wybieracz/IoT-Smart-Light-Firmware/Documentation/Circuit_diagram.pdf

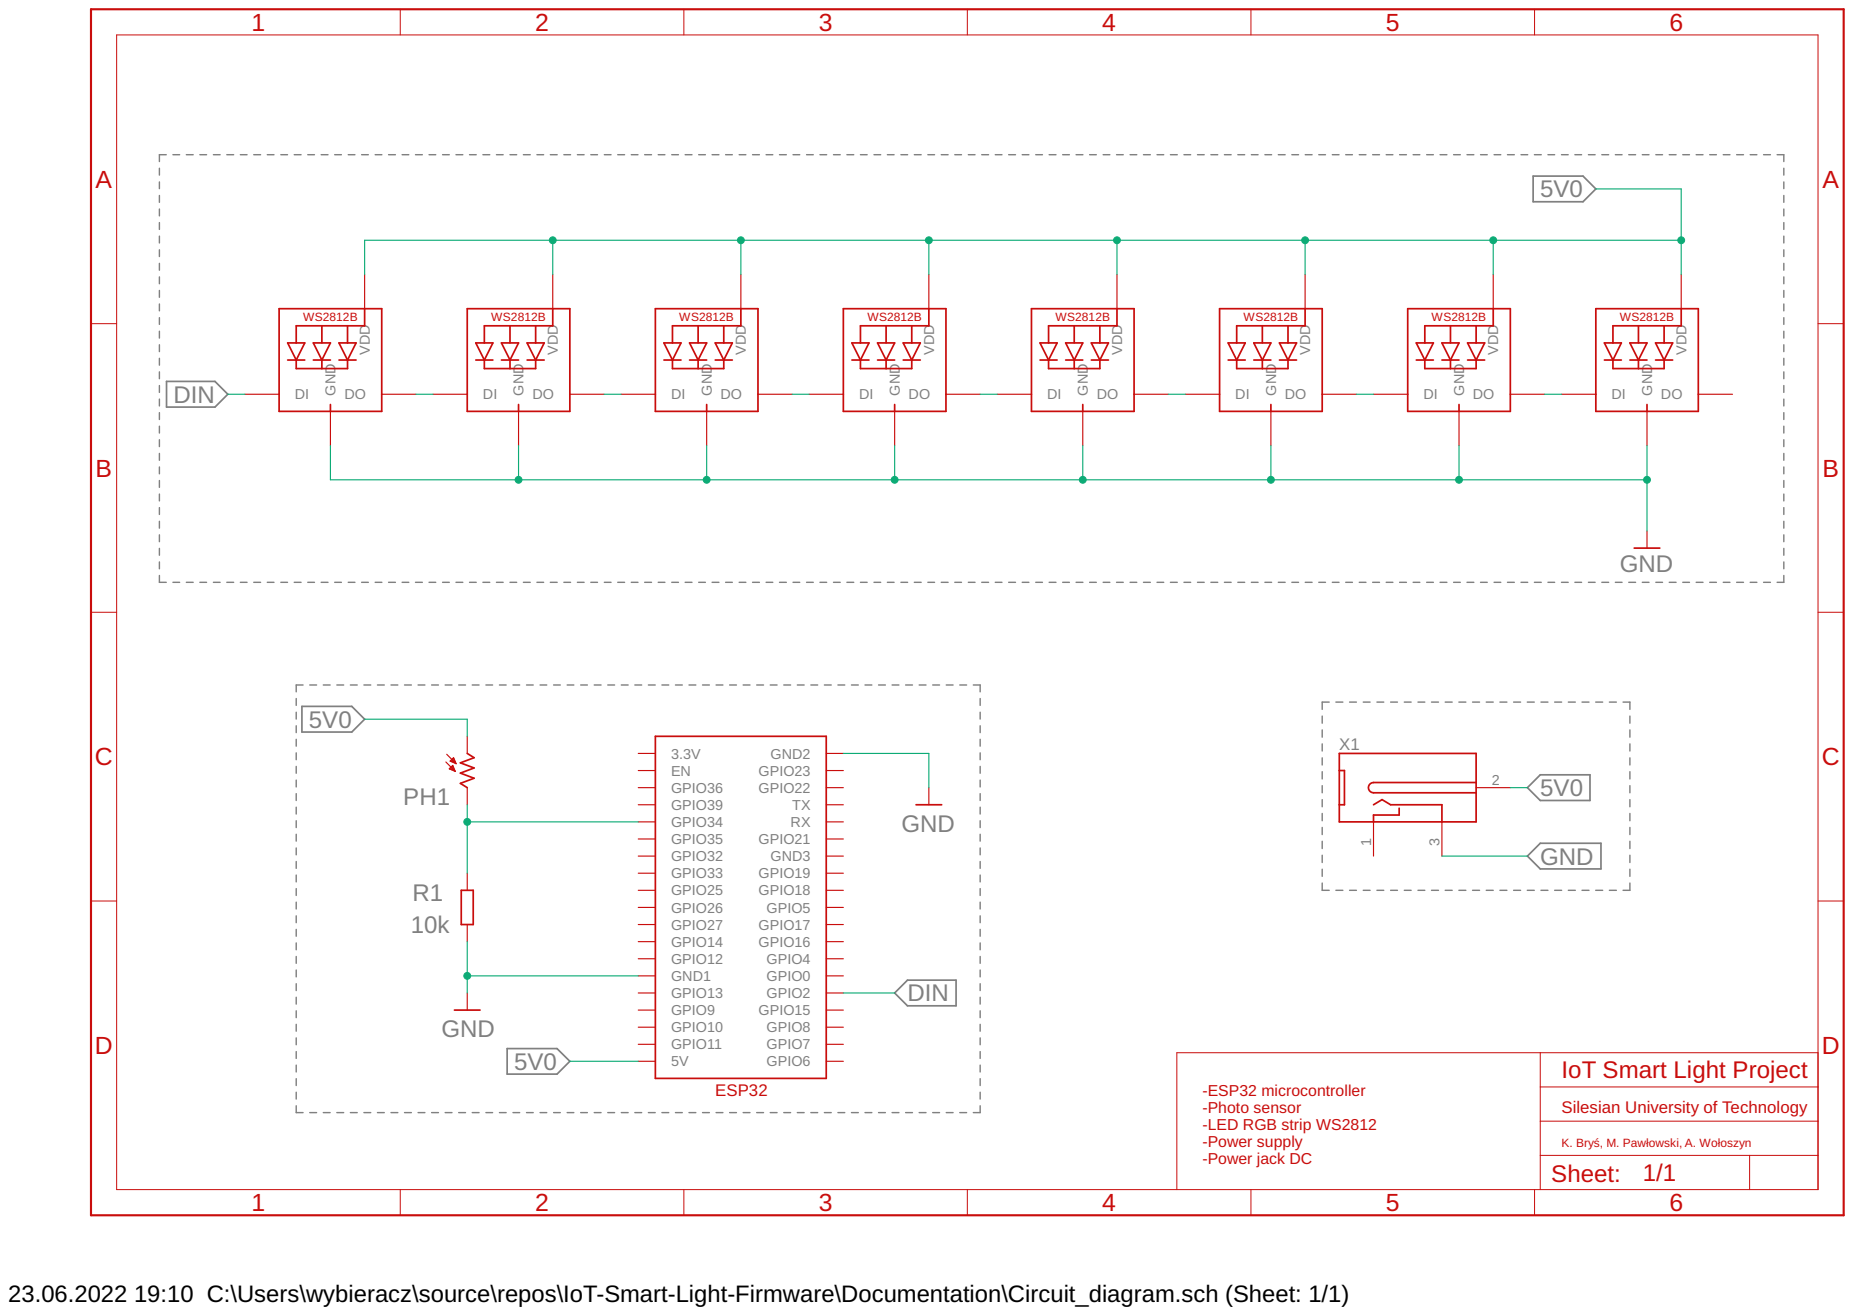
[picture p10: page 1]

IoT Smart Light Project

Silesian University of Technology

23.06.2022 19:10 C:\Users\wybieracz\source\repos\IoT-Smart-Light-Firmware\Documentation\Circuit_diagram.sch (Sheet: 1/1)
