wybieracz/IoT-Smart-Light-Firmware/Documentation/Circuit_diagram.sch

## EAGLE design Documentation/Circuit_diagram.sch (2022-06-23)

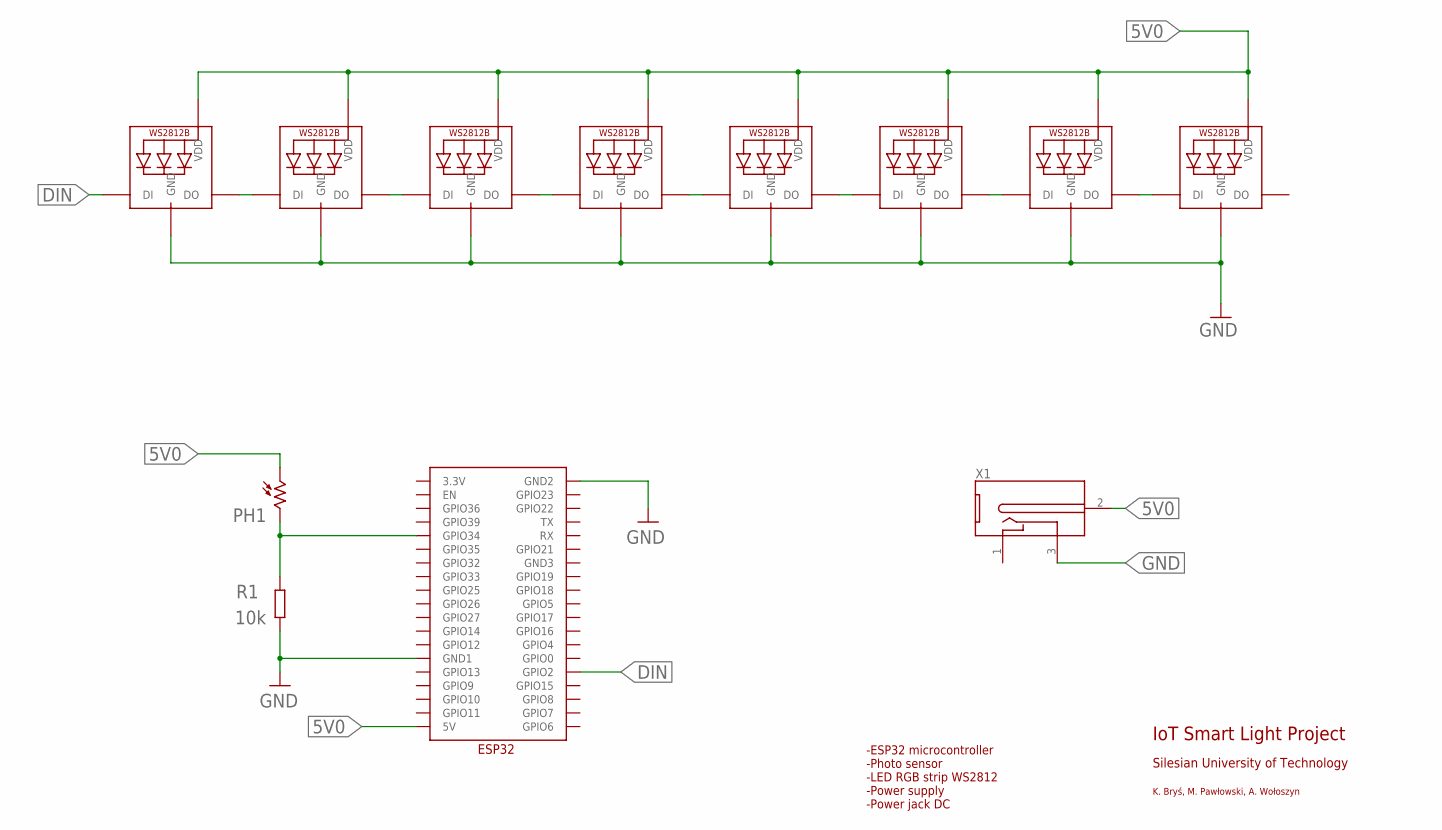
[picture p11: schematic Circuit_diagram.sch]

Parts:
LED1, LED2, LED3, LED4, LED5, LED6, LED7, LED8: WS2812B3535; LED3535
PH1: W5560_11; W55XX
R1: 10k; 0204V
U$2: ESP32
X1: DC-2.1MM-5MM; DC-21MM

Connections:
5V0: LED1.2 (VDD), LED2.2 (VDD), LED3.2 (VDD), LED4.2 (VDD), LED5.2 (VDD), LED6.2 (VDD), LED7.2 (VDD), LED8.2 (VDD), PH1.1, U$2.5V, X1.2 (3)
DIN: LED1.1 (DI), U$2.GPIO2
GND: R1.2, U$2.GND1, U$2.GND2, X1.3 (2)
unnamed: LED1.3 (DO), LED2.1 (DI)
unnamed: LED2.3 (DO), LED4.1 (DI)
unnamed: LED4.3 (DO), LED7.1 (DI)
unnamed: LED3.1 (DI), LED7.3 (DO)
unnamed: LED3.3 (DO), LED8.1 (DI)
unnamed: LED6.1 (DI), LED8.3 (DO)
unnamed: LED5.1 (DI), LED6.3 (DO)
unnamed: LED1.4 (GND), LED2.4 (GND), LED3.4 (GND), LED4.4 (GND), LED5.4 (GND), LED6.4 (GND), LED7.4 (GND), LED8.4 (GND)
unnamed: PH1.2, R1.1, U$2.GPIO34

Notes on the sheet:
IoT Smart Light Project
Silesian University of Technology
K. Bryś, M. Pawłowski, A. Wołoszyn
-ESP32 microcontroller -Photo sensor -LED RGB strip WS2812 -Power supply -Power jack DC
