wybieracz/IoT-Smart-Light-Firmware/(commit log)

2022-03-31 Merged PR 4: feature/led-blynk
    feature: make led blinking
2022-04-20 feature: electronic circuit diagram
    [Circuit_diagram.sch]
2022-05-19 Merged PR 16: feature/led-controller
    - feature: receive direct method
    - refactor: split code to separated files
    - feature: handle toggleLed direct method
    - docs: add directory for documentation
    - feature: deal with led strip
2022-06-13 Merged PR 17: feature/light-detector
    - feature: read from photoresistor
    - feature: set brightness based on light detector
    - fix: change LightDetector due to hardware change
    [AzIoTClient.cpp, AzIoTMethodHandlers.cpp, AzIoTMethodHandlers.h, FirmwareESP32.ino, LedController.cpp, LedController.h, LightDetector.cpp, LightDetector.h]
2022-06-21 Merged PR 24: fix/getStatus-function
    - fix: change RGB values from int to string
    - fix: change AzIoTConfig import
    [AzIoTClient.h, AzIoTMethodHandlers.cpp, WiFiConnection.h]
2022-06-21 Merged PR 25: fix/circut-esp32-pinout
    fix: add photos and fix circut schemat
    [Circuit_diagram.sch]
2022-06-23 fix: instruction fix
    [Circuit_diagram.sch]
